sparkfunX/MicroMod_Carrier_Big_Display/Hardware/Production/ordering_instructions.txt

panel size, 141x152mm
PCB thickness, 1.6mm
number of layers, 2
soldermask color, Black
silkscreen color, White
oz copper, 1oz
finish, HASL lead free
stencils, none
pcs per panel, 6
min trace width, 0.1778mm / 0.0070in
min drill size, 0.3048mm / 0.0120in
