sparkfunX/MicroMod_Carrier_Big_Display/(threads)

Thread 1 (2021-03-13):

HDMI_5V is not correct

ralphjy, 2021-03-13:
I am having a problem getting my HDMI monitors to recognize this board as an HDMI source.

It appears that the schematic for the HDMI_5V is incorrect as it should be an output from this board not an input from the monitor.

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

nseidle, 2021-03-16:
This is a truly experimental board. We cannot guarantee it will work with all monitors. That said, we've had it working on multiple monitors around our office in the US and our collaborators in the UK.

The board was designed with the hopes of getting enough current from a TV to run theRP2040. The HDMI spec says

    A sink shall not draw more than 55 mA from the power signal when powered on

See [here](https://www.ti.com/lit/an/snva412c/snva412c.pdf?ts=1615898507918) for more info. While it would have been convenient to power the board directly from a TV, it never worked. We always needed an external power supply.

This board *is* designed to be a HDMI source but we weren't comfortable pushing current into our TVs over the 5V pin. You are welcome to jumper over D5 but I don't think I would recommend it.

Closed 2021-03-16.
