sparkfunX/MicroMod_Carrier_Big_Display/Hardware/Schematic.pdf

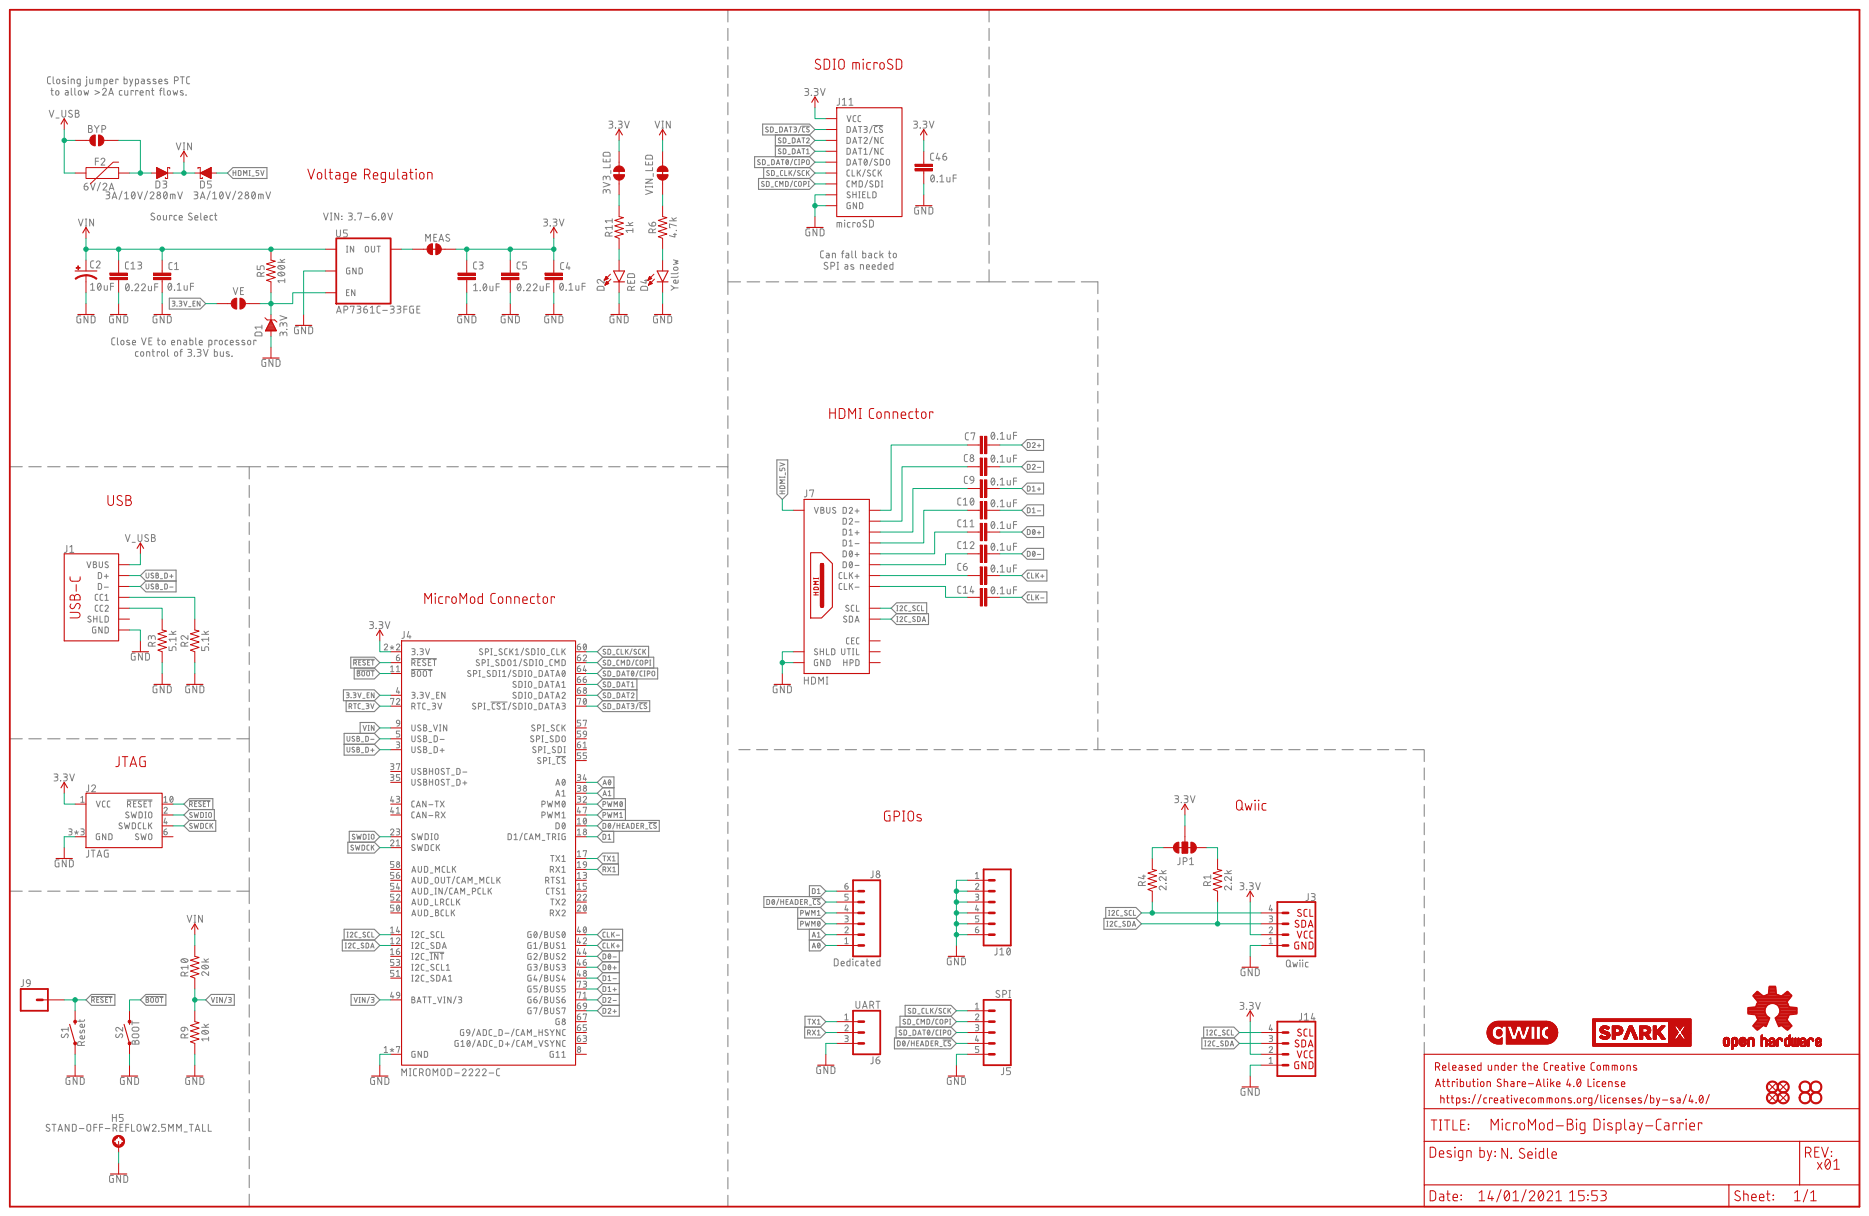
[picture p1: page 1]
