sparkfunX/MicroMod_Carrier_Big_Display/Hardware/MicroMod-Big Display-Carrier.brd

## EAGLE design Hardware/MicroMod-Big Display-Carrier.brd (2021-01-07)

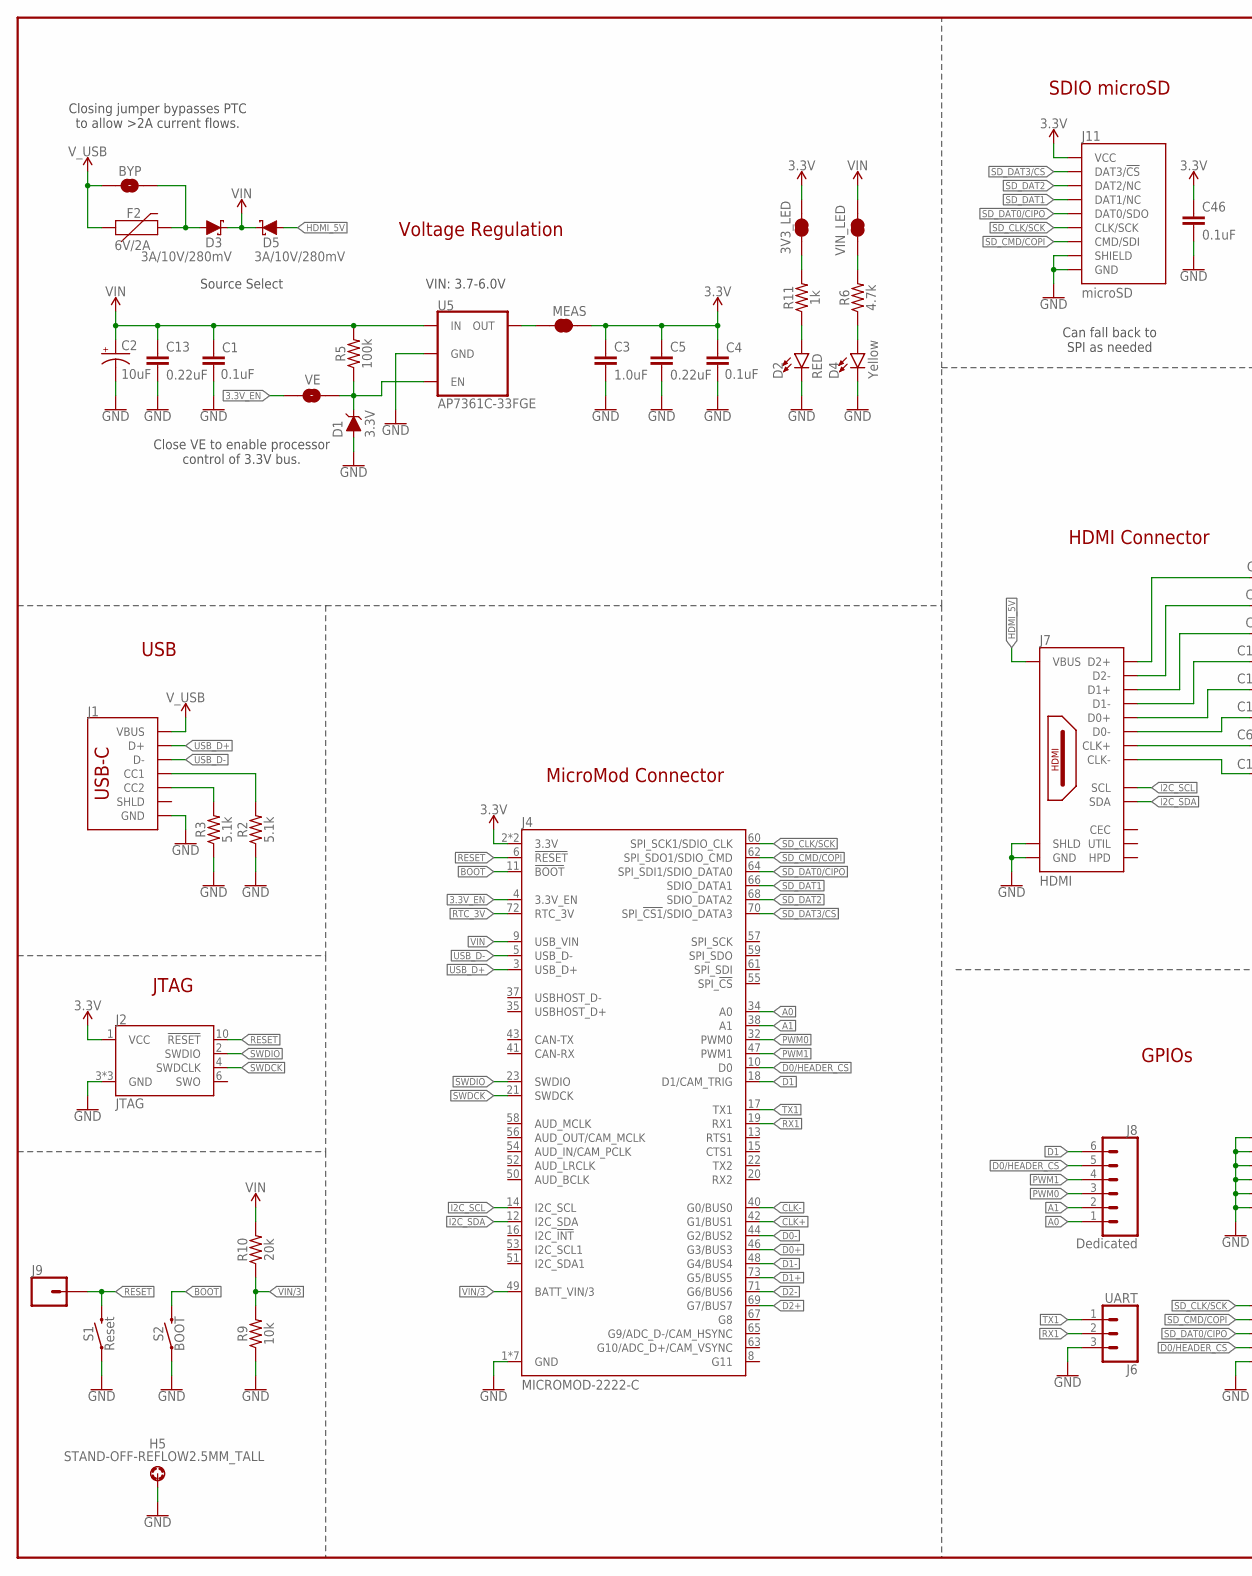
[picture p2: schematic MicroMod-Big Display-Carrier.sch, part in row 1, column 1]

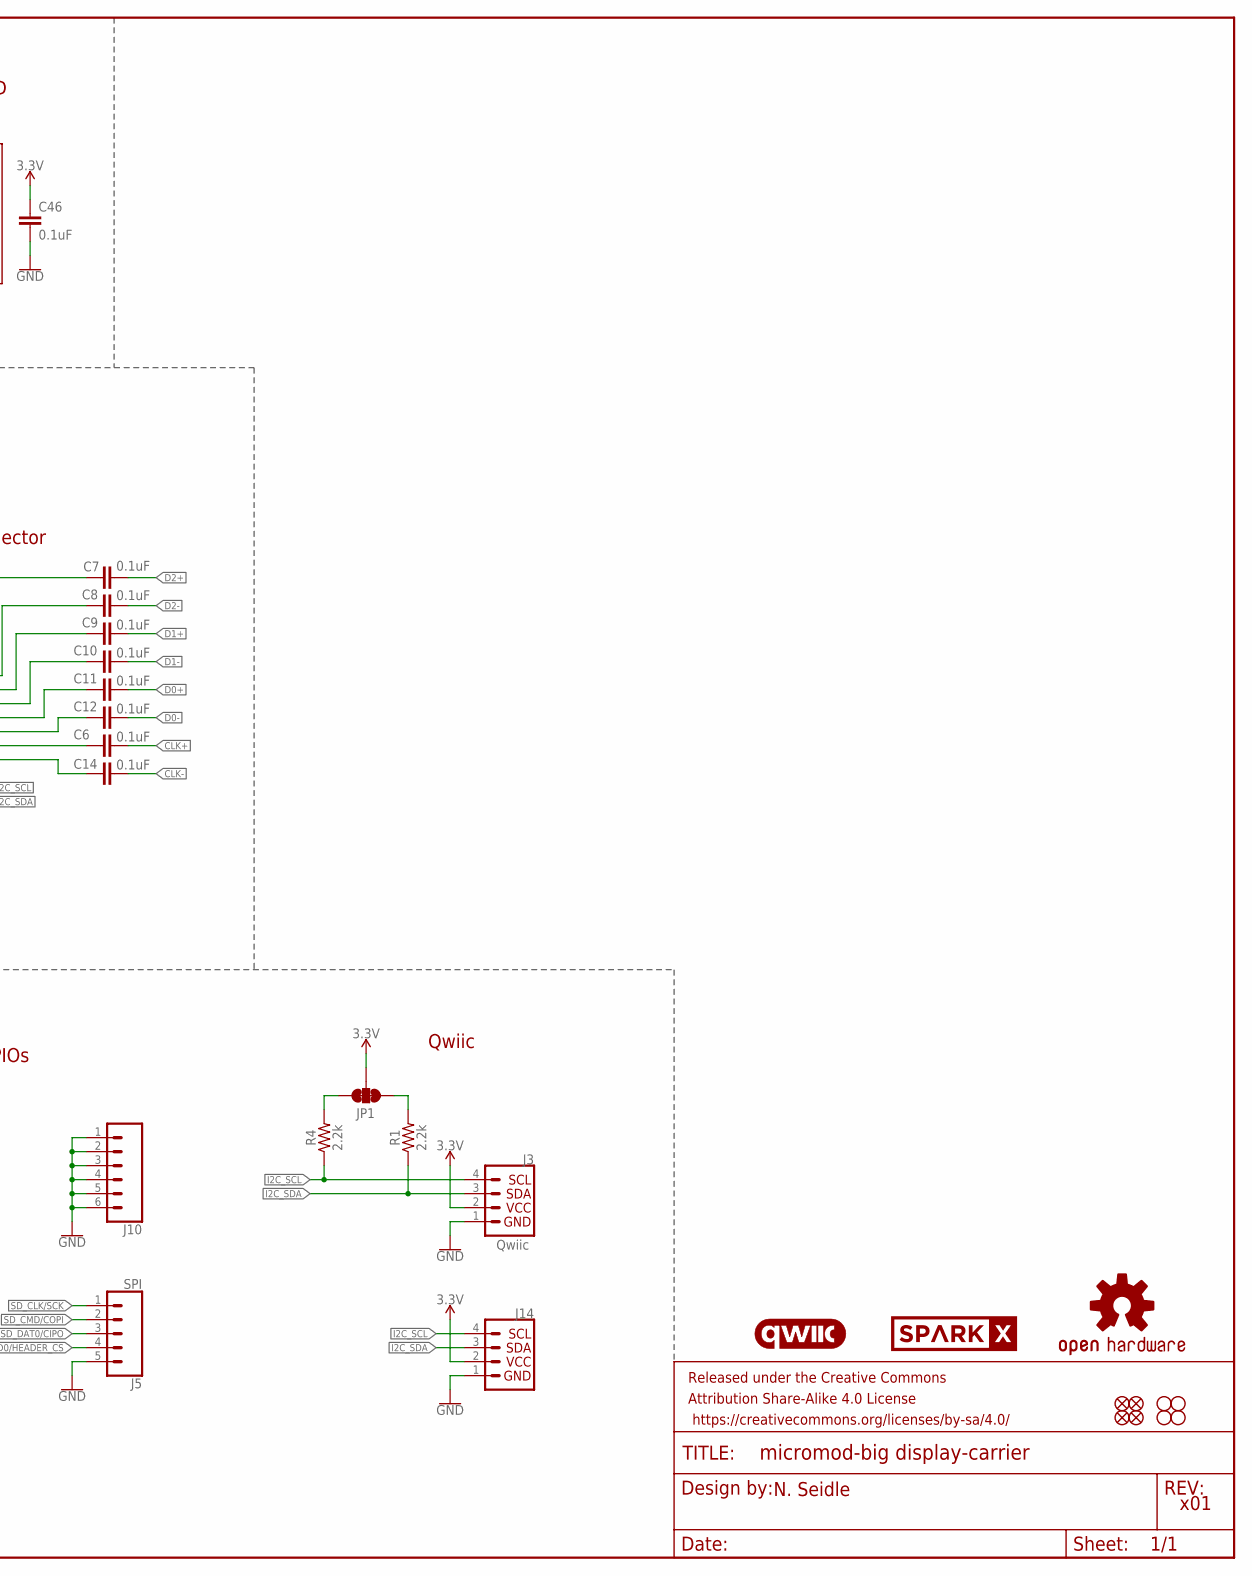
[picture p3: schematic MicroMod-Big Display-Carrier.sch, part in row 1, column 2]

Parts:
3V3_LED: JUMPER-SMT_2_NC_TRACE_SILK; SMT-JUMPER_2_NC_TRACE_SILK
BYP: JUMPER-SMT_2_NO_SILK; SMT-JUMPER_2_NO_SILK
C1, C4, C6, C7, C8, C9, C10, C11, C12, C14, C46: 0.1uF; 0603
C2: 10uF; EIA3216
C3: 1.0uF; 0603
C5, C13: 0.22uF; 0603
D1: 3.3V; SOD-323
D2: RED; LED-0603
D3, D5: 3A/10V/280mV; SOD-323
D4: Yellow; LED-0603
F2: 6V/2A; 1210
FD1, FD2, FD3, FD4: FIDUCIALUFIDUCIAL; FIDUCIAL-MICRO
FRAME1: FRAME-LEDGER; CREATIVE_COMMONS
H1, H2, H3, H4: STAND-OFF
H5: STAND-OFF-REFLOW2.5MM_TALL; STAND-OFF-REFLOW-M2.5
J1: USB_C_2-LAYER_PADS; USB-C-16P-2LAYER-PADS
J2: JTAG; 2X5-PTH-1.27MM
J3: Qwiic; JST04_1MM_RA
J4: MICROMOD-2222-C; M.2-CONNECTOR-E
J5: SPI; 1X05_NO_SILK
J6: UART; 1X03_NO_SILK
J7: HDMI; MOLEX_HDMI_208658-1051
J8: Dedicated; 1X06_NO_SILK
J9: CONN_01PTH_NO_SILK_YES_STOP; 1X01_NO_SILK
J10: CONN_06NO_SILK_NO_POP; 1X06_NO_SILK
J11: microSD; MICRO-SD-SOCKET
J14: I2C_STANDARD_NO_SILK; 1X04_NO_SILK
JP1: JUMPER-SMT_3_2-NC_TRACE_SILK; SMT-JUMPER_3_2-NC_TRACE_SILK
LOGO2: QWIIC_LOGO_CONNECTOR; QWIIC_5.5MM
LOGO3: OSHW-LOGOMINI; OSHW-LOGO-MINI
MEAS: JUMPER-COMBO_2_NC_TRACE; COMBO-JUMPER_2_NC_TRACE
R1, R4: 2.2k; 0603
R2, R3: 5.1k; 0603
R5: 100k; 0603
R6: 4.7k; 0603
R9: 10k; 0603
R10: 20k; 0603
R11: 1k; 0603
S1: Reset; TACTILE_SWITCH_SMD_5.2MM
S2: BOOT; TACTILE_SWITCH_SMD_5.2MM
U5: AP7361C-33FGE; UDFN-8
U$1: SPARKX-LOGO4; SPARKX-MEDIUM
VE: JUMPER-SMT_2_NO_SILK; SMT-JUMPER_2_NO_SILK
VIN_LED: JUMPER-SMT_2_NC_TRACE_SILK; SMT-JUMPER_2_NC_TRACE_SILK

Connections:
3.3V: 3V3_LED.2, C3.1, C4.1, C5.1, C46.1, J2.1 (VCC), J3.2, J4.2 (3.3V), J4.74 (3.3V), J11.VCC, J14.2, JP1.2, MEAS.2, MEAS.4 (2)
3.3V_EN: J4.4 (3.3V_EN), VE.1
!BOOT!: J4.11 (!BOOT!), S2.3 (2), S2.4 (2)
!RESET!: J2.10 (!RESET), J4.6 (!RESET!), J9.1, S1.3 (2), S1.4 (2)
A0: J4.34 (A0), J8.1
A1: J4.38 (A1), J8.2
CLK+: C6.1, J4.42 (G1/BUS1)
CLK-: C14.1, J4.40 (G0/BUS0)
D0+: C11.1, J4.46 (G3/BUS3)
D0-: C12.1, J4.44 (G2/BUS2)
D0/HEADER_!CS!: J4.10 (D0), J5.4, J8.5
D1: J4.18 (D1/CAM_TRIG), J8.6
D1+: C9.1, J4.73 (G5/BUS5)
D1-: C10.1, J4.48 (G4/BUS4)
D2+: C7.1, J4.69 (G7/BUS7)
D2-: C8.1, J4.71 (G6/BUS6)
GND: C1.2, C2.-, C3.2, C4.2, C5.2, C13.2, C46.2, D1.A, D2.C, D4.C, H5.1, J1.GND, J1.GND2 (GND), J2.3 (GND), J2.5 (GND), J2.9 (GND), J3.1, J4.1 (GND), J4.7 (GND), J4.33 (GND), J4.36 (GND), J4.39 (GND), J4.45 (GND), J4.75 (GND), J5.5, J6.3, J7.2 (GND), J7.5 (GND), J7.8 (GND), J7.11 (GND), J7.17 (GND), J7.MH1 (SHLD), J7.MH2 (SHLD), J7.MH3 (SHLD), J7.MH4 (SHLD), J10.1, J10.2, J10.3, J10.4, J10.5, J10.6, J11.CD1 (SHIELD), J11.GND, J11.GND1 (GND), J11.GND3 (GND), J14.1, R2.1, R3.1, R9.1, S1.1, S1.2 (1), S2.1, S2.2 (1), U5.4 (GND), U5.EP (GND)
HDMI_5V: D5.A, J7.18 (VBUS)
I2C_SCL: J3.4, J4.14 (I2C_SCL), J7.15 (SCL), J14.4, R4.1
I2C_SDA: J3.3, J4.12 (I2C_SDA), J7.16 (SDA), J14.3, R1.1
unnamed: R6.2, VIN_LED.1
unnamed: JP1.3, R4.2
unnamed: JP1.1, R1.2
unnamed: C7.2, J7.1 (D2+)
unnamed: C8.2, J7.3 (D2-)
unnamed: 3V3_LED.1, R11.2
unnamed: D2.A, R11.1
unnamed: D4.A, R6.1
unnamed: C9.2, J7.4 (D1+)
unnamed: J1.A5 (CC1), R2.2
unnamed: J1.B5 (CC2), R3.2
unnamed: D1.C, R5.1, U5.5 (EN), VE.2
unnamed: C10.2, J7.6 (D1-)
unnamed: C11.2, J7.7 (D0+)
unnamed: C12.2, J7.9 (D0-)
unnamed: C6.2, J7.10 (CLK+)
unnamed: C14.2, J7.12 (CLK-)
unnamed: BYP.2, D3.A, F2.2
PWM0: J4.32 (PWM0), J8.3
PWM1: J4.47 (PWM1), J8.4
RTC_3V: J4.72 (RTC_3V)
RX1: J4.19 (RX1), J6.2
SD_CLK/SCK: J4.60 (SPI_SCK1/SDIO_CLK), J5.1, J11.SCLK (CLK/SCK)
SD_CMD/COPI: J4.62 (SPI_SDO1/SDIO_CMD), J5.2, J11.DI/CMD (CMD/SDI)
SD_DAT0/CIPO: J4.64 (SPI_SDI1/SDIO_DATA0), J5.3, J11.DO/DAT0 (DAT0/SDO)
SD_DAT1: J4.66 (SDIO_DATA1), J11.DAT1 (DAT1/NC)
SD_DAT2: J4.68 (SDIO_DATA2), J11.DAT2 (DAT2/NC)
SD_DAT3/!CS!: J4.70 (SPI_!CS1!/SDIO_DATA3), J11.CS/DAT3 (DAT3/!CS!)
SWDCK: J2.4 (SWDCLK), J4.21 (SWDCK)
SWDIO: J2.2 (SWDIO), J4.23 (SWDIO)
TX1: J4.17 (TX1), J6.1
USB_D+: J1.A6 (D+), J1.B6 (D+), J4.3 (USB_D+)
USB_D-: J1.A7 (D-), J1.B7 (D-), J4.5 (USB_D-)
VIN: C1.1, C2.+, C13.1, D3.C, D5.C, J4.9 (USB_VIN), R5.2, R10.2, U5.8 (IN), VIN_LED.2
VIN/3: J4.49 (BATT_VIN/3), R9.2, R10.1
VREG_3.3V: MEAS.1, MEAS.3 (1), U5.1 (OUT)
V_USB: BYP.1, F2.1, J1.VBUS1 (VBUS), J1.VBUS2 (VBUS)

Notes on the sheet:
SDIO microSD
Closing jumper bypasses PTC to allow >2A current flows.
JTAG
USB
GPIOs
Qwiic
Voltage Regulation
MicroMod Connector
N. Seidle
x01
VIN: 3.7-6.0V
Close VE to enable processor control of 3.3V bus.
HDMI Connector
Can fall back to SPI as needed
Source Select

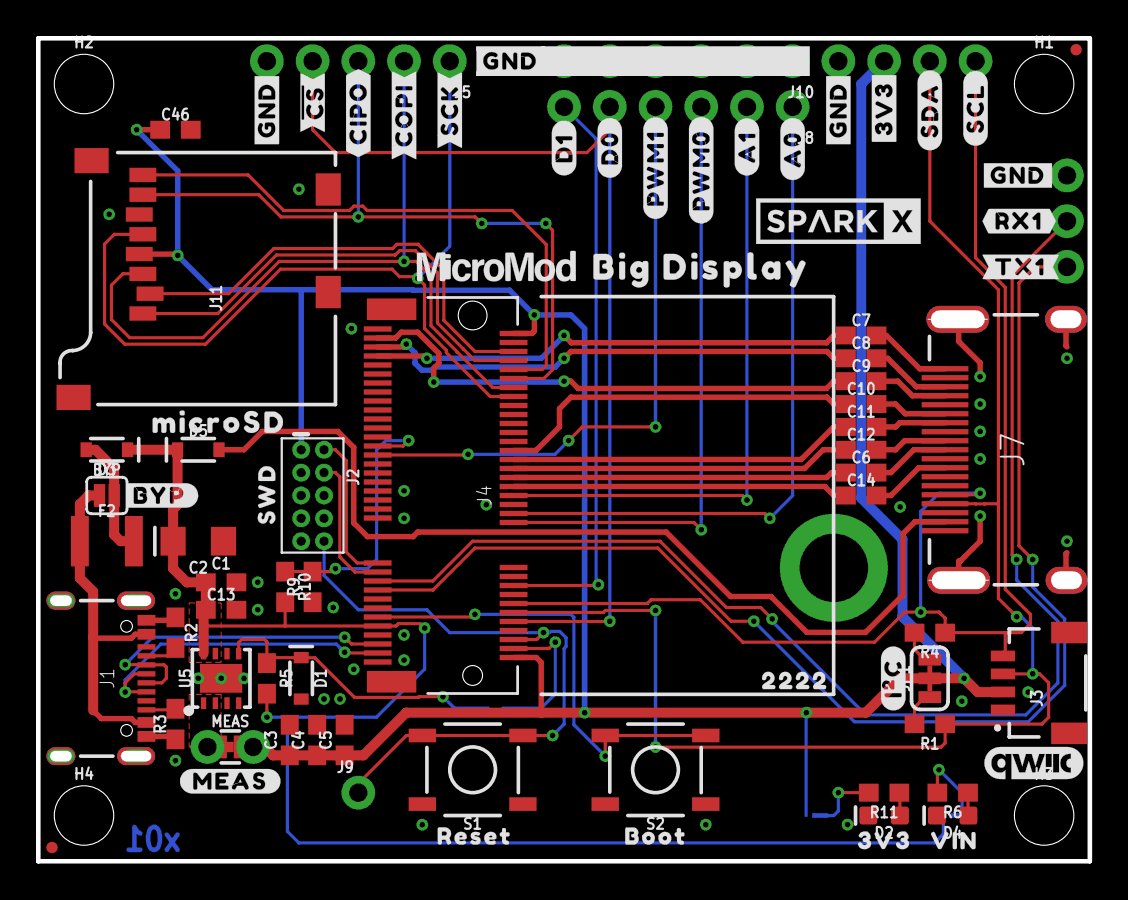
[picture p4: board MicroMod-Big Display-Carrier.brd from above]

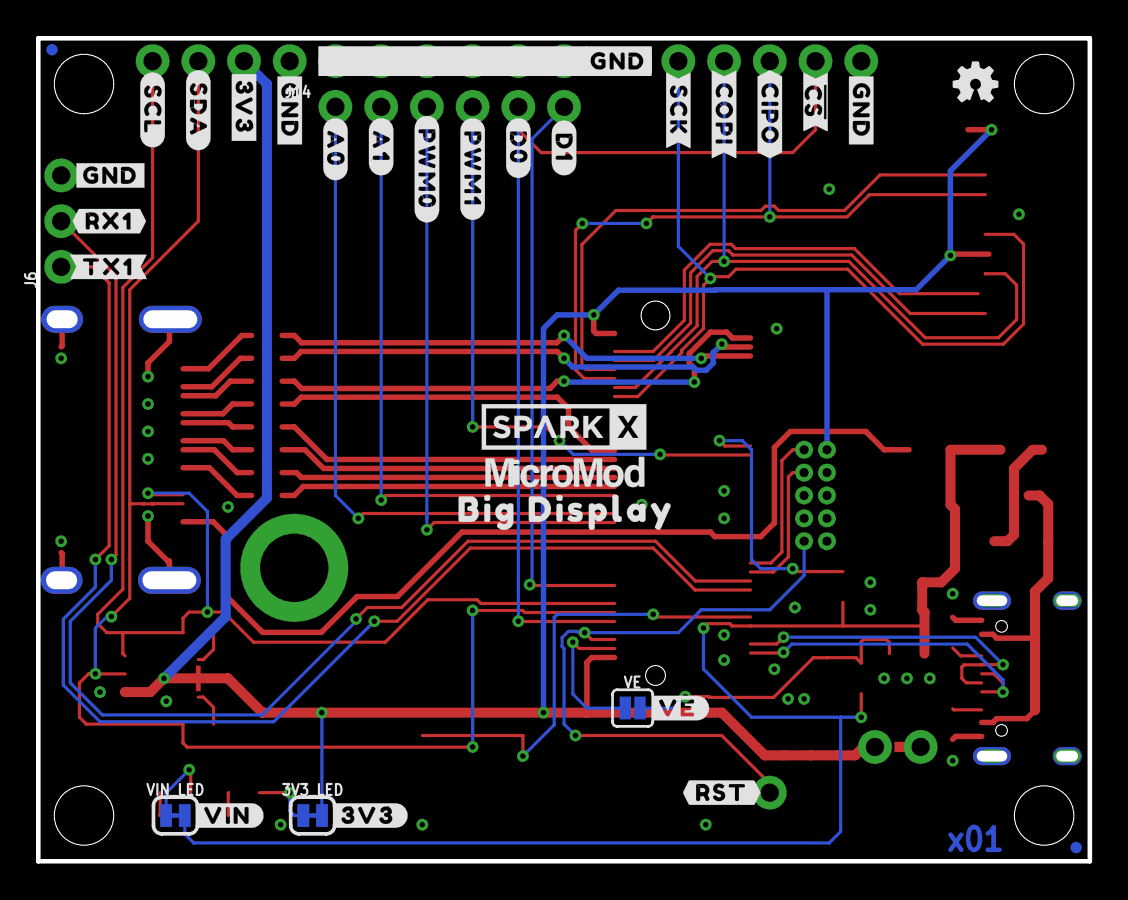
[picture p5: board MicroMod-Big Display-Carrier.brd from below]

Board: 2 copper layers, 58.4 x 45.7 mm, 121 parts (34 on the bottom side), 56 nets.

Other parts of the board:
U$2: MICROSD0
U$3, U$5: BIG_DISPLAY0
U$4: #3V3#0
U$6, U$7: #A0#5
U$8, U$9: #A1#4
U$10, U$25: #D0#1
U$11, U$12, U$15, U$16: #GND#0
U$13, U$14: #3V3#1
U$17: #RST#1
U$18: #VE#0
U$19: #MEAS#2
U$20: #VIN#1
U$21: SWD0
U$22: SPARKX-LOGO4; SPARKX-MEDIUM
U$23: #I�C#0
U$24, U$34: MICROMOD_LOGO_.35
U$29, U$31: #D1#0
U$32, U$41: #PWM0#3
U$33: #BYP#1
U$35, U$68: ##CS##3
U$36: 3V37
U$38: 22223
U$40: BOOT5
U$42, U$49: #PWM1#2
U$43, U$44: #SCL#3
U$45: RESET6
U$46: VIN8
U$50, U$51: #SDA#2
U$69, U$70: #CIPO#2
U$71, U$72: #COPI#1
U$73, U$74, U$81, U$82: #GND#4
U$75, U$76: #RX1#6
U$77, U$78: #SCK#0
U$79, U$80: #TX1#5
