sparkfunX/MicroMod_Carrier_Big_Display/Hardware/Production/MicroMod-Big Display-Carrier-Panel.brd

## EAGLE design Hardware/Production/MicroMod-Big Display-Carrier-Panel.brd (2021-01-07)

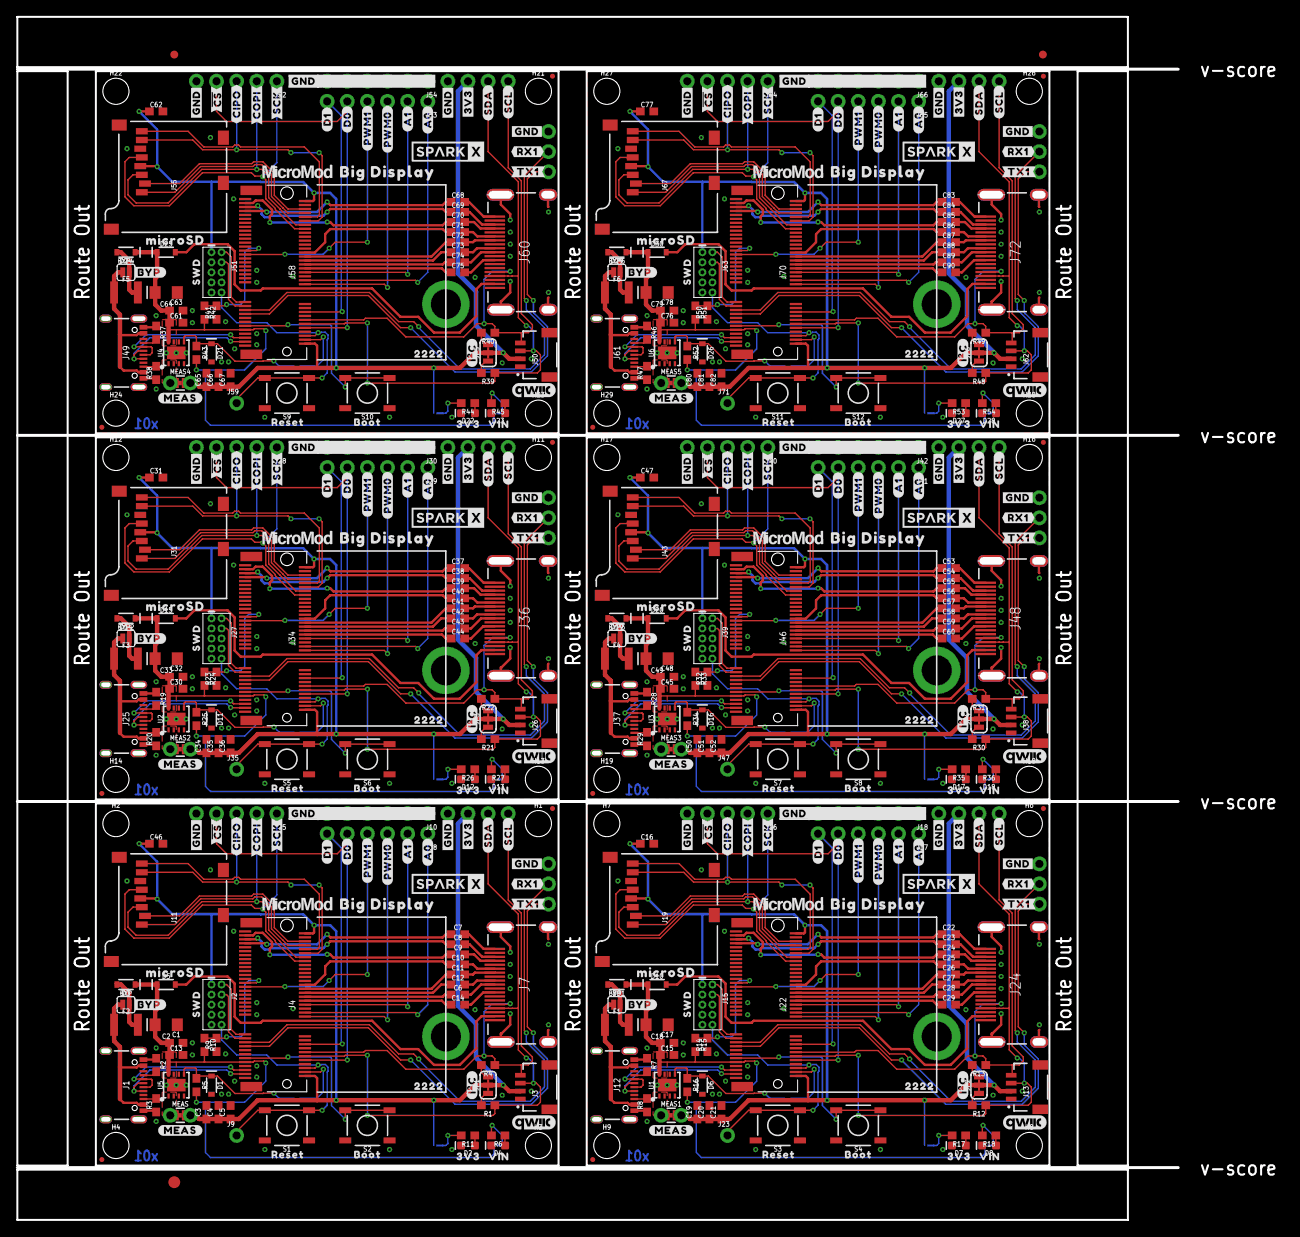
[picture p6: board MicroMod-Big Display-Carrier-Panel.brd from above]

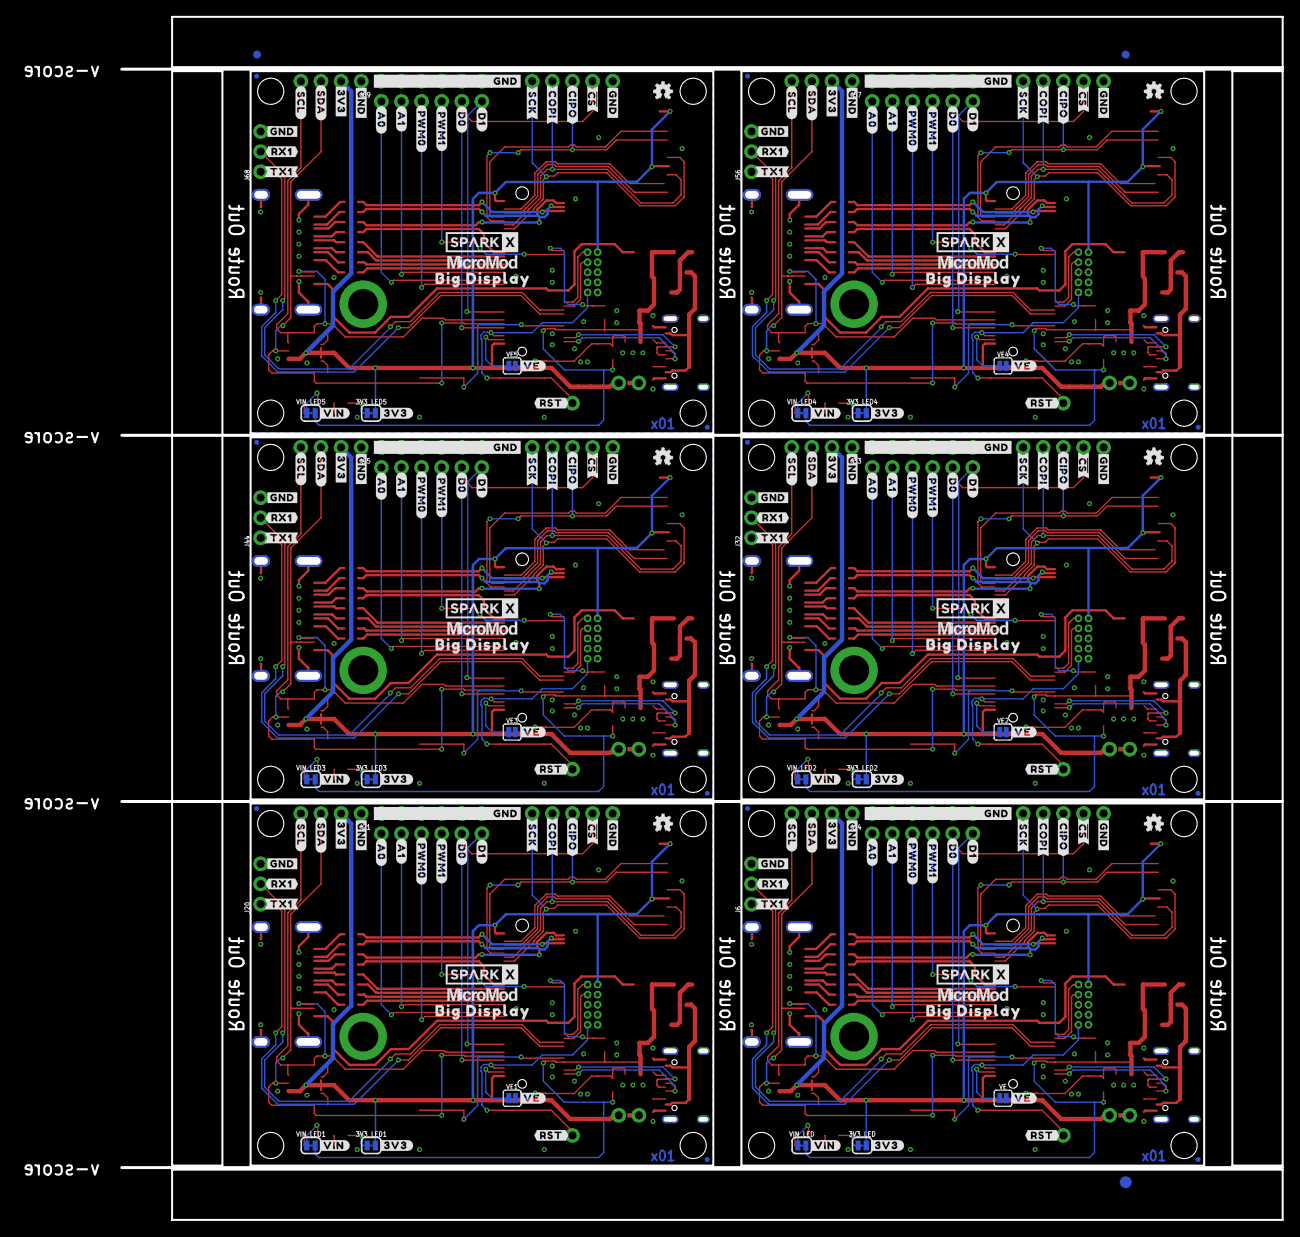
[picture p7: board MicroMod-Big Display-Carrier-Panel.brd from below]

Board: 2 copper layers, 146.6 x 151.9 mm, 726 parts (207 on the bottom side), 336 nets.

Parts:
3V3_LED, 3V3_LED1, 3V3_LED2, 3V3_LED3, 3V3_LED4, 3V3_LED5: SMT-JUMPER_2_NC_TRACE_SILK
BYP, BYP1, BYP2, BYP3, BYP4, BYP5: JUMPER-SMT_2_NO_SILK; SMT-JUMPER_2_NO_SILK
C1, C4, C6, C7, C8, C9, C10, C11, C12, C14, C16, C17, C20, C22, C23, C24, C25, C26, C27, C28, C29, C31, C32, C35, C37, C38, C39, C40, C41, C42, C43, C44, C46, C47, C48, C51, C53, C54, C55, C56, C57, C58, C59, C60, C62, C63, C66, C68, C69, C70, C71, C72, C73, C74, C75, C77, C78, C81, C83, C84, C85, C86, C87, C88, C89, C90: 0.1uF; 0603
C2, C18, C33, C49, C64, C79: 10uF; EIA3216
C3, C19, C34, C50, C65, C80: 1.0uF; 0603
C5, C13, C15, C21, C30, C36, C45, C52, C61, C67, C76, C82: 0.22uF; 0603
D1, D6, D11, D16, D21, D26: 3.3V; SOD-323
D2, D7, D12, D17, D22, D27: RED; LED-0603
D3, D5, D9, D10, D14, D15, D19, D20, D24, D25, D29, D30: 3A/10V/280mV; SOD-323
D4, D8, D13, D18, D23, D28: Yellow; LED-0603
E$1, E$2, E$3, E$4: FIDUCIAL-1X2
E$5, E$6: FIDUCIAL-1.5X3
F1, F2, F3, F4, F5, F6: 6V/2A; 1210
FD1, FD2, FD3, FD4, FD5, FD6, FD7, FD8, FD9, FD10, FD11, FD12, FD13, FD14, FD15, FD16, FD17, FD18, FD19, FD20, FD21, FD22, FD23, FD24: FIDUCIALUFIDUCIAL; FIDUCIAL-MICRO
H1, H2, H3, H4, H6, H7, H8, H9, H11, H12, H13, H14, H16, H17, H18, H19, H21, H22, H23, H24, H26, H27, H28, H29: STAND-OFF
H5, H10, H15, H20, H25, H30: STAND-OFF-REFLOW2.5MM_TALL; STAND-OFF-REFLOW-M2.5
J1, J12, J25, J37, J49, J61: USB-C-16P-2LAYER-PADS
J2, J15, J27, J39, J51, J63: JTAG; 2X5-PTH-1.27MM
J3, J13, J26, J38, J50, J62: Qwiic; JST04_1MM_RA
J4, J22, J34, J46, J58, J70: MICROMOD-2222-C; M.2-CONNECTOR-E
J5, J16, J28, J40, J52, J64: SPI; 1X05_NO_SILK
J6, J20, J32, J44, J56, J68: UART; 1X03_NO_SILK
J7, J24, J36, J48, J60, J72: HDMI; MOLEX_HDMI_208658-1051
J8, J17, J29, J41, J53, J65: Dedicated; 1X06_NO_SILK
J9, J23, J35, J47, J59, J71: 1X01_NO_SILK
J10, J18, J30, J42, J54, J66: 1X06_NO_SILK
J11, J19, J31, J43, J55, J67: microSD; MICRO-SD-SOCKET
J14, J21, J33, J45, J57, J69: 1X04_NO_SILK
JP1, JP2, JP3, JP4, JP5, JP6: SMT-JUMPER_3_2-NC_TRACE_SILK
LOGO1, LOGO2, LOGO5, LOGO7, LOGO9, LOGO11: QWIIC_LOGO_CONNECTOR; QWIIC_5.5MM
LOGO3, LOGO4, LOGO6, LOGO8, LOGO10, LOGO12: OSHW-LOGOMINI; OSHW-LOGO-MINI
MEAS, MEAS1, MEAS2, MEAS3, MEAS4, MEAS5: COMBO-JUMPER_2_NC_TRACE
R1, R4, R12, R13, R21, R22, R30, R31, R39, R40, R48, R49: 2.2k; 0603
R2, R3, R7, R8, R19, R20, R28, R29, R37, R38, R46, R47: 5.1k; 0603
R5, R16, R25, R34, R43, R52: 100k; 0603
R6, R18, R27, R36, R45, R54: 4.7k; 0603
R9, R14, R23, R32, R41, R50: 10k; 0603
R10, R15, R24, R33, R42, R51: 20k; 0603
R11, R17, R26, R35, R44, R53: 1k; 0603
S1, S3, S5, S7, S9, S11: Reset; TACTILE_SWITCH_SMD_5.2MM
S2, S4, S6, S8, S10, S12: BOOT; TACTILE_SWITCH_SMD_5.2MM
U1, U2, U3, U4, U5, U6: AP7361C-33FGE; UDFN-8
U$1, U$22, U$113, U$114, U$171, U$172, U$229, U$230, U$287, U$288, U$345, U$346: SPARKX-LOGO4; SPARKX-MEDIUM
U$2, U$112, U$170, U$228, U$286, U$344: MICROSD0
U$3, U$5, U$115, U$116, U$173, U$174, U$231, U$232, U$289, U$290, U$347, U$348: BIG_DISPLAY0
U$4, U$110, U$168, U$226, U$284, U$342: #3V3#0
U$6, U$7, U$62, U$63, U$135, U$136, U$193, U$194, U$251, U$252, U$309, U$310: #A0#5
U$8, U$9, U$64, U$65, U$137, U$138, U$195, U$196, U$253, U$254, U$311, U$312: #A1#4
U$10, U$25, U$66, U$67, U$139, U$140, U$197, U$198, U$255, U$256, U$313, U$314: #D0#1
U$11, U$12, U$15, U$16, U$89, U$90, U$93, U$94, U$147, U$148, U$151, U$152, U$205, U$206, U$209, U$210, U$263, U$264, U$267, U$268, U$321, U$322, U$325, U$326: #GND#0
U$13, U$14, U$91, U$92, U$149, U$150, U$207, U$208, U$265, U$266, U$323, U$324: #3V3#1
U$17, U$107, U$165, U$223, U$281, U$339: #RST#1
U$18, U$108, U$166, U$224, U$282, U$340: #VE#0
U$19, U$104, U$162, U$220, U$278, U$336: #MEAS#2
U$20, U$111, U$169, U$227, U$285, U$343: #VIN#1
U$21, U$105, U$163, U$221, U$279, U$337: SWD0
U$23, U$109, U$167, U$225, U$283, U$341: #I�C#0
U$24, U$26, U$27, U$34, U$117, U$118, U$175, U$176, U$233, U$234, U$291, U$292: MICROMOD_LOGO_.35
U$28, U$30, U$35, U$68, U$119, U$120, U$177, U$178, U$235, U$236, U$293, U$294: ##CS##3
U$29, U$31, U$83, U$84, U$141, U$142, U$199, U$200, U$257, U$258, U$315, U$316: #D1#0
U$32, U$41, U$85, U$86, U$143, U$144, U$201, U$202, U$259, U$260, U$317, U$318: #PWM0#3
U$33, U$106, U$164, U$222, U$280, U$338: #BYP#1
U$36, U$99, U$157, U$215, U$273, U$331: 3V37
U$37, U$39, U$69, U$70, U$121, U$122, U$179, U$180, U$237, U$238, U$295, U$296: #CIPO#2
U$38, U$100, U$158, U$216, U$274, U$332: 22223
U$40, U$101, U$159, U$217, U$275, U$333: BOOT5
U$42, U$49, U$87, U$88, U$145, U$146, U$203, U$204, U$261, U$262, U$319, U$320: #PWM1#2
U$43, U$44, U$95, U$96, U$153, U$154, U$211, U$212, U$269, U$270, U$327, U$328: #SCL#3
U$45, U$102, U$160, U$218, U$276, U$334: RESET6
U$46, U$103, U$161, U$219, U$277, U$335: VIN8
U$47, U$48, U$71, U$72, U$123, U$124, U$181, U$182, U$239, U$240, U$297, U$298: #COPI#1
U$50, U$51, U$97, U$98, U$155, U$156, U$213, U$214, U$271, U$272, U$329, U$330: #SDA#2
U$52, U$53, U$60, U$61, U$73, U$74, U$81, U$82, U$125, U$126, U$133, U$134, U$183, U$184, U$191, U$192, U$241, U$242, U$249, U$250, U$299, U$300, U$307, U$308: #GND#4
U$54, U$55, U$75, U$76, U$127, U$128, U$185, U$186, U$243, U$244, U$301, U$302: #RX1#6
U$56, U$57, U$77, U$78, U$129, U$130, U$187, U$188, U$245, U$246, U$303, U$304: #SCK#0
U$58, U$59, U$79, U$80, U$131, U$132, U$189, U$190, U$247, U$248, U$305, U$306: #TX1#5
VE, VE1, VE2, VE3, VE4, VE5: SMT-JUMPER_2_NO_SILK
VIN_LED, VIN_LED1, VIN_LED2, VIN_LED3, VIN_LED4, VIN_LED5: SMT-JUMPER_2_NC_TRACE_SILK

Connections:
3.3V: 3V3_LED.2, C3.1, C4.1, C5.1, C46.1, J2.1, J3.2, J4.2, J4.74, J11.VCC, J14.2, JP1.2, MEAS.2, MEAS.4
3.3V1: 3V3_LED1.2, C16.1, C19.1, C20.1, C21.1, J13.2, J15.1, J19.VCC, J21.2, J22.2, J22.74, JP2.2, MEAS1.2, MEAS1.4
3.3V2: 3V3_LED2.2, C31.1, C34.1, C35.1, C36.1, J26.2, J27.1, J31.VCC, J33.2, J34.2, J34.74, JP3.2, MEAS2.2, MEAS2.4
3.3V3: 3V3_LED3.2, C47.1, C50.1, C51.1, C52.1, J38.2, J39.1, J43.VCC, J45.2, J46.2, J46.74, JP4.2, MEAS3.2, MEAS3.4
3.3V4: 3V3_LED4.2, C62.1, C65.1, C66.1, C67.1, J50.2, J51.1, J55.VCC, J57.2, J58.2, J58.74, JP5.2, MEAS4.2, MEAS4.4
3.3V5: 3V3_LED5.2, C77.1, C80.1, C81.1, C82.1, J62.2, J63.1, J67.VCC, J69.2, J70.2, J70.74, JP6.2, MEAS5.2, MEAS5.4
3.3V_EN: J4.4, VE.1
3.3V_EN1: J22.4, VE1.1
3.3V_EN2: J34.4, VE2.1
3.3V_EN3: J46.4, VE3.1
3.3V_EN4: J58.4, VE4.1
3.3V_EN5: J70.4, VE5.1
!BOOT!: J4.11, S2.3, S2.4
!BOOT!1: J22.11, S4.3, S4.4
!BOOT!2: J34.11, S6.3, S6.4
!BOOT!3: J46.11, S8.3, S8.4
!BOOT!4: J58.11, S10.3, S10.4
!BOOT!5: J70.11, S12.3, S12.4
!RESET!: J2.10, J4.6, J9.1, S1.3, S1.4
!RESET!1: J15.10, J22.6, J23.1, S3.3, S3.4
!RESET!2: J27.10, J34.6, J35.1, S5.3, S5.4
!RESET!3: J39.10, J46.6, J47.1, S7.3, S7.4
!RESET!4: J51.10, J58.6, J59.1, S9.3, S9.4
!RESET!5: J63.10, J70.6, J71.1, S11.3, S11.4
A0: J4.34, J8.1
A1: J4.38, J8.2
A2: J17.1, J22.34
A3: J17.2, J22.38
A4: J29.1, J34.34
A5: J29.2, J34.38
A6: J41.1, J46.34
A7: J41.2, J46.38
A8: J53.1, J58.34
A9: J53.2, J58.38
A10: J65.1, J70.34
A11: J65.2, J70.38
CLK+: C6.1, J4.42
CLK+1: C28.1, J22.42
CLK+2: C43.1, J34.42
CLK+3: C59.1, J46.42
CLK+4: C74.1, J58.42
CLK+5: C89.1, J70.42
CLK-: C14.1, J4.40
CLK-1: C29.1, J22.40
CLK-2: C44.1, J34.40
CLK-3: C60.1, J46.40
CLK-4: C75.1, J58.40
CLK-5: C90.1, J70.40
D0+: C11.1, J4.46
D0+1: C26.1, J22.46
D0+2: C41.1, J34.46
D0+3: C57.1, J46.46
D0+4: C72.1, J58.46
D0+5: C87.1, J70.46
D0-: C12.1, J4.44
D0-1: C27.1, J22.44
D0-2: C42.1, J34.44
D0-3: C58.1, J46.44
D0-4: C73.1, J58.44
D0-5: C88.1, J70.44
D0/HEADER_!CS!: J4.10, J5.4, J8.5
D0/HEADER_!CS!1: J16.4, J17.5, J22.10
D0/HEADER_!CS!2: J28.4, J29.5, J34.10
D0/HEADER_!CS!3: J40.4, J41.5, J46.10
D0/HEADER_!CS!4: J52.4, J53.5, J58.10
D0/HEADER_!CS!5: J64.4, J65.5, J70.10
D1: J4.18, J8.6
D1+: C9.1, J4.73
D1+1: C24.1, J22.73
D1+2: C39.1, J34.73
D1+3: C55.1, J46.73
D1+4: C70.1, J58.73
D1+5: C85.1, J70.73
D1-: C10.1, J4.48
D1-1: C25.1, J22.48
D1-2: C40.1, J34.48
D1-3: C56.1, J46.48
D1-4: C71.1, J58.48
D1-5: C86.1, J70.48
D2: J17.6, J22.18
D2+: C7.1, J4.69
D2+1: C22.1, J22.69
D2+2: C37.1, J34.69
D2+3: C53.1, J46.69
D2+4: C68.1, J58.69
D2+5: C83.1, J70.69
D2-: C8.1, J4.71
D2-1: C23.1, J22.71
D2-2: C38.1, J34.71
D2-3: C54.1, J46.71
D2-4: C69.1, J58.71
D2-5: C84.1, J70.71
D3: J29.6, J34.18
D4: J41.6, J46.18
D5: J53.6, J58.18
D6: J65.6, J70.18
GND: C1.2, C2.-, C3.2, C4.2, C5.2, C13.2, C46.2, D1.A, D2.C, D4.C, H5.1, J1.GND, J1.GND2, J2.3, J2.5, J2.9, J3.1, J4.1, J4.7, J4.33, J4.36, J4.39, J4.45, J4.75, J5.5, J6.3, J7.2, J7.5, J7.8, J7.11, J7.17, J7.MH1, J7.MH2, J7.MH3, J7.MH4, J10.1, J10.2, J10.3, J10.4, J10.5, J10.6, J11.CD1, J11.GND, J11.GND1, J11.GND3, J14.1, R2.1, R3.1, R9.1, S1.1, S1.2, S2.1, S2.2, U5.4, U5.EP
GND1: C15.2, C16.2, C17.2, C18.-, C19.2, C20.2, C21.2, D6.A, D7.C, D8.C, H10.1, J12.GND, J12.GND2, J13.1, J15.3, J15.5, J15.9, J16.5, J18.1, J18.2, J18.3, J18.4, J18.5, J18.6, J19.CD1, J19.GND, J19.GND1, J19.GND3, J20.3, J21.1, J22.1, J22.7, J22.33, J22.36, J22.39, J22.45, J22.75, J24.2, J24.5, J24.8, J24.11, J24.17, J24.MH1, J24.MH2, J24.MH3, J24.MH4, R7.1, R8.1, R14.1, S3.1, S3.2, S4.1, S4.2, U1.4, U1.EP
GND2: C30.2, C31.2, C32.2, C33.-, C34.2, C35.2, C36.2, D11.A, D12.C, D13.C, H15.1, J25.GND, J25.GND2, J26.1, J27.3, J27.5, J27.9, J28.5, J30.1, J30.2, J30.3, J30.4, J30.5, J30.6, J31.CD1, J31.GND, J31.GND1, J31.GND3, J32.3, J33.1, J34.1, J34.7, J34.33, J34.36, J34.39, J34.45, J34.75, J36.2, J36.5, J36.8, J36.11, J36.17, J36.MH1, J36.MH2, J36.MH3, J36.MH4, R19.1, R20.1, R23.1, S5.1, S5.2, S6.1, S6.2, U2.4, U2.EP
GND3: C45.2, C47.2, C48.2, C49.-, C50.2, C51.2, C52.2, D16.A, D17.C, D18.C, H20.1, J37.GND, J37.GND2, J38.1, J39.3, J39.5, J39.9, J40.5, J42.1, J42.2, J42.3, J42.4, J42.5, J42.6, J43.CD1, J43.GND, J43.GND1, J43.GND3, J44.3, J45.1, J46.1, J46.7, J46.33, J46.36, J46.39, J46.45, J46.75, J48.2, J48.5, J48.8, J48.11, J48.17, J48.MH1, J48.MH2, J48.MH3, J48.MH4, R28.1, R29.1, R32.1, S7.1, S7.2, S8.1, S8.2, U3.4, U3.EP
GND4: C61.2, C62.2, C63.2, C64.-, C65.2, C66.2, C67.2, D21.A, D22.C, D23.C, H25.1, J49.GND, J49.GND2, J50.1, J51.3, J51.5, J51.9, J52.5, J54.1, J54.2, J54.3, J54.4, J54.5, J54.6, J55.CD1, J55.GND, J55.GND1, J55.GND3, J56.3, J57.1, J58.1, J58.7, J58.33, J58.36, J58.39, J58.45, J58.75, J60.2, J60.5, J60.8, J60.11, J60.17, J60.MH1, J60.MH2, J60.MH3, J60.MH4, R37.1, R38.1, R41.1, S9.1, S9.2, S10.1, S10.2, U4.4, U4.EP
GND5: C76.2, C77.2, C78.2, C79.-, C80.2, C81.2, C82.2, D26.A, D27.C, D28.C, H30.1, J61.GND, J61.GND2, J62.1, J63.3, J63.5, J63.9, J64.5, J66.1, J66.2, J66.3, J66.4, J66.5, J66.6, J67.CD1, J67.GND, J67.GND1, J67.GND3, J68.3, J69.1, J70.1, J70.7, J70.33, J70.36, J70.39, J70.45, J70.75, J72.2, J72.5, J72.8, J72.11, J72.17, J72.MH1, J72.MH2, J72.MH3, J72.MH4, R46.1, R47.1, R50.1, S11.1, S11.2, S12.1, S12.2, U6.4, U6.EP
HDMI_5V: D5.A, J7.18
HDMI_5V1: D10.A, J24.18
HDMI_5V2: D15.A, J36.18
HDMI_5V3: D20.A, J48.18
HDMI_5V4: D25.A, J60.18
HDMI_5V5: D30.A, J72.18
I2C_SCL: J3.4, J4.14, J7.15, J14.4, R4.1
I2C_SCL1: J13.4, J21.4, J22.14, J24.15, R13.1
I2C_SCL2: J26.4, J33.4, J34.14, J36.15, R22.1
I2C_SCL3: J38.4, J45.4, J46.14, J48.15, R31.1
I2C_SCL4: J50.4, J57.4, J58.14, J60.15, R40.1
I2C_SCL5: J62.4, J69.4, J70.14, J72.15, R49.1
I2C_SDA: J3.3, J4.12, J7.16, J14.3, R1.1
I2C_SDA1: J13.3, J21.3, J22.12, J24.16, R12.1
I2C_SDA2: J26.3, J33.3, J34.12, J36.16, R21.1
I2C_SDA3: J38.3, J45.3, J46.12, J48.16, R30.1
I2C_SDA4: J50.3, J57.3, J58.12, J60.16, R39.1
I2C_SDA5: J62.3, J69.3, J70.12, J72.16, R48.1
unnamed: R6.2, VIN_LED.1
unnamed: JP1.3, R4.2
unnamed: JP1.1, R1.2
unnamed: C7.2, J7.1
unnamed: C8.2, J7.3
unnamed: 3V3_LED.1, R11.2
unnamed: D2.A, R11.1
unnamed: D4.A, R6.1
unnamed: C9.2, J7.4
unnamed: J1.A5, R2.2
unnamed: J1.B5, R3.2
unnamed: D1.C, R5.1, U5.5, VE.2
unnamed: C10.2, J7.6
unnamed: C11.2, J7.7
unnamed: C12.2, J7.9
unnamed: C6.2, J7.10
unnamed: C14.2, J7.12
unnamed: BYP.2, D3.A, F2.2
unnamed: J12.A5, R7.2
unnamed: J12.B5, R8.2
unnamed: JP2.3, R13.2
unnamed: JP2.1, R12.2
unnamed: 3V3_LED1.1, R17.2
unnamed: D7.A, R17.1
unnamed: R18.2, VIN_LED1.1
unnamed: D8.A, R18.1
unnamed: D6.C, R16.1, U1.5, VE1.2
unnamed: C22.2, J24.1
unnamed: C23.2, J24.3
unnamed: C24.2, J24.4
unnamed: C25.2, J24.6
unnamed: C28.2, J24.10
unnamed: C29.2, J24.12
unnamed: C26.2, J24.7
unnamed: C27.2, J24.9
unnamed: BYP1.2, D9.A, F1.2
unnamed: J25.A5, R19.2
unnamed: J25.B5, R20.2
unnamed: JP3.3, R22.2
unnamed: JP3.1, R21.2
unnamed: 3V3_LED2.1, R26.2
unnamed: D12.A, R26.1
unnamed: R27.2, VIN_LED2.1
unnamed: D13.A, R27.1
unnamed: D11.C, R25.1, U2.5, VE2.2
unnamed: C37.2, J36.1
unnamed: C38.2, J36.3
unnamed: C39.2, J36.4
unnamed: C40.2, J36.6
unnamed: C43.2, J36.10
unnamed: C44.2, J36.12
unnamed: C41.2, J36.7
unnamed: C42.2, J36.9
unnamed: BYP2.2, D14.A, F3.2
unnamed: J37.A5, R28.2
unnamed: J37.B5, R29.2
unnamed: JP4.3, R31.2
unnamed: JP4.1, R30.2
unnamed: 3V3_LED3.1, R35.2
unnamed: D17.A, R35.1
unnamed: R36.2, VIN_LED3.1
unnamed: D18.A, R36.1
unnamed: D16.C, R34.1, U3.5, VE3.2
unnamed: C53.2, J48.1
unnamed: C54.2, J48.3
unnamed: C55.2, J48.4
unnamed: C56.2, J48.6
unnamed: C59.2, J48.10
unnamed: C60.2, J48.12
unnamed: C57.2, J48.7
unnamed: C58.2, J48.9
unnamed: BYP3.2, D19.A, F4.2
unnamed: J49.A5, R37.2
unnamed: J49.B5, R38.2
unnamed: JP5.3, R40.2
unnamed: JP5.1, R39.2
unnamed: 3V3_LED4.1, R44.2
unnamed: D22.A, R44.1
unnamed: R45.2, VIN_LED4.1
unnamed: D23.A, R45.1
unnamed: D21.C, R43.1, U4.5, VE4.2
unnamed: C68.2, J60.1
unnamed: C69.2, J60.3
unnamed: C70.2, J60.4
unnamed: C71.2, J60.6
unnamed: C74.2, J60.10
unnamed: C75.2, J60.12
unnamed: C72.2, J60.7
unnamed: C73.2, J60.9
unnamed: BYP4.2, D24.A, F5.2
unnamed: J61.A5, R46.2
unnamed: J61.B5, R47.2
unnamed: JP6.3, R49.2
unnamed: JP6.1, R48.2
unnamed: 3V3_LED5.1, R53.2
unnamed: D27.A, R53.1
unnamed: R54.2, VIN_LED5.1
unnamed: D28.A, R54.1
unnamed: D26.C, R52.1, U6.5, VE5.2
unnamed: C83.2, J72.1
unnamed: C84.2, J72.3
unnamed: C85.2, J72.4
unnamed: C86.2, J72.6
unnamed: C89.2, J72.10
unnamed: C90.2, J72.12
unnamed: C87.2, J72.7
unnamed: C88.2, J72.9
unnamed: BYP5.2, D29.A, F6.2
PWM0: J4.32, J8.3
PWM1: J4.47, J8.4
PWM2: J17.3, J22.32
PWM3: J17.4, J22.47
PWM4: J29.3, J34.32
PWM5: J29.4, J34.47
PWM6: J41.3, J46.32
PWM7: J41.4, J46.47
PWM8: J53.3, J58.32
PWM9: J53.4, J58.47
PWM10: J65.3, J70.32
PWM11: J65.4, J70.47
RX1: J4.19, J6.2
RX2: J20.2, J22.19
RX3: J32.2, J34.19
RX4: J44.2, J46.19
RX5: J56.2, J58.19
RX6: J68.2, J70.19
SD_CLK/SCK: J4.60, J5.1, J11.SCLK
SD_CLK/SCK1: J16.1, J19.SCLK, J22.60
SD_CLK/SCK2: J28.1, J31.SCLK, J34.60
SD_CLK/SCK3: J40.1, J43.SCLK, J46.60
SD_CLK/SCK4: J52.1, J55.SCLK, J58.60
SD_CLK/SCK5: J64.1, J67.SCLK, J70.60
SD_CMD/COPI: J4.62, J5.2, J11.DI/CMD
SD_CMD/COPI1: J16.2, J19.DI/CMD, J22.62
SD_CMD/COPI2: J28.2, J31.DI/CMD, J34.62
SD_CMD/COPI3: J40.2, J43.DI/CMD, J46.62
SD_CMD/COPI4: J52.2, J55.DI/CMD, J58.62
SD_CMD/COPI5: J64.2, J67.DI/CMD, J70.62
SD_DAT0/CIPO: J4.64, J5.3, J11.DO/DAT0
SD_DAT0/CIPO1: J16.3, J19.DO/DAT0, J22.64
SD_DAT0/CIPO2: J28.3, J31.DO/DAT0, J34.64
SD_DAT0/CIPO3: J40.3, J43.DO/DAT0, J46.64
SD_DAT0/CIPO4: J52.3, J55.DO/DAT0, J58.64
SD_DAT0/CIPO5: J64.3, J67.DO/DAT0, J70.64
SD_DAT1: J4.66, J11.DAT1
SD_DAT2: J4.68, J11.DAT2
SD_DAT3: J19.DAT1, J22.66
SD_DAT3/!CS!: J4.70, J11.CS/DAT3
SD_DAT3/!CS!1: J19.CS/DAT3, J22.70
SD_DAT3/!CS!2: J31.CS/DAT3, J34.70
SD_DAT3/!CS!3: J43.CS/DAT3, J46.70
SD_DAT3/!CS!4: J55.CS/DAT3, J58.70
SD_DAT3/!CS!5: J67.CS/DAT3, J70.70
SD_DAT4: J19.DAT2, J22.68
SD_DAT5: J31.DAT1, J34.66
SD_DAT6: J31.DAT2, J34.68
SD_DAT7: J43.DAT1, J46.66
SD_DAT8: J43.DAT2, J46.68
SD_DAT9: J55.DAT1, J58.66
SD_DAT10: J55.DAT2, J58.68
SD_DAT11: J67.DAT1, J70.66
SD_DAT12: J67.DAT2, J70.68
SWDCK: J2.4, J4.21
SWDCK1: J15.4, J22.21
SWDCK2: J27.4, J34.21
SWDCK3: J39.4, J46.21
SWDCK4: J51.4, J58.21
SWDCK5: J63.4, J70.21
SWDIO: J2.2, J4.23
SWDIO1: J15.2, J22.23
SWDIO2: J27.2, J34.23
SWDIO3: J39.2, J46.23
SWDIO4: J51.2, J58.23
SWDIO5: J63.2, J70.23
TX1: J4.17, J6.1
TX2: J20.1, J22.17
TX3: J32.1, J34.17
TX4: J44.1, J46.17
TX5: J56.1, J58.17
TX6: J68.1, J70.17
USB_D+: J1.A6, J1.B6, J4.3
USB_D+1: J12.A6, J12.B6, J22.3
USB_D+2: J25.A6, J25.B6, J34.3
USB_D+3: J37.A6, J37.B6, J46.3
USB_D+4: J49.A6, J49.B6, J58.3
USB_D+5: J61.A6, J61.B6, J70.3
USB_D-: J1.A7, J1.B7, J4.5
USB_D-1: J12.A7, J12.B7, J22.5
USB_D-2: J25.A7, J25.B7, J34.5
USB_D-3: J37.A7, J37.B7, J46.5
USB_D-4: J49.A7, J49.B7, J58.5
USB_D-5: J61.A7, J61.B7, J70.5
VIN: C1.1, C2.+, C13.1, D3.C, D5.C, J4.9, R5.2, R10.2, U5.8, VIN_LED.2
VIN1: C15.1, C17.1, C18.+, D9.C, D10.C, J22.9, R15.2, R16.2, U1.8, VIN_LED1.2
VIN2: C30.1, C32.1, C33.+, D14.C, D15.C, J34.9, R24.2, R25.2, U2.8, VIN_LED2.2
VIN3: C45.1, C48.1, C49.+, D19.C, D20.C, J46.9, R33.2, R34.2, U3.8, VIN_LED3.2
VIN4: C61.1, C63.1, C64.+, D24.C, D25.C, J58.9, R42.2, R43.2, U4.8, VIN_LED4.2
VIN5: C76.1, C78.1, C79.+, D29.C, D30.C, J70.9, R51.2, R52.2, U6.8, VIN_LED5.2
VIN/1: J22.49, R14.2, R15.1
VIN/2: J34.49, R23.2, R24.1
VIN/3: J4.49, R9.2, R10.1
VIN/4: J46.49, R32.2, R33.1
VIN/5: J58.49, R41.2, R42.1
VIN/6: J70.49, R50.2, R51.1
VREG_3.3V: MEAS.1, MEAS.3, U5.1
VREG_3.3V1: MEAS1.1, MEAS1.3, U1.1
VREG_3.3V2: MEAS2.1, MEAS2.3, U2.1
VREG_3.3V3: MEAS3.1, MEAS3.3, U3.1
VREG_3.3V4: MEAS4.1, MEAS4.3, U4.1
VREG_3.3V5: MEAS5.1, MEAS5.3, U6.1
V_USB: BYP.1, F2.1, J1.VBUS1, J1.VBUS2
V_USB1: BYP1.1, F1.1, J12.VBUS1, J12.VBUS2
V_USB2: BYP2.1, F3.1, J25.VBUS1, J25.VBUS2
V_USB3: BYP3.1, F4.1, J37.VBUS1, J37.VBUS2
V_USB4: BYP4.1, F5.1, J49.VBUS1, J49.VBUS2
V_USB5: BYP5.1, F6.1, J61.VBUS1, J61.VBUS2
