sparkfunX/MicroMod_Carrier_Big_Display/(commit log)

2021-01-07 Update silk
    [MicroMod-Big Display-Carrier-Panel.GBL, MicroMod-Big Display-Carrier-Panel.GBO, MicroMod-Big Display-Carrier-Panel.GBP, MicroMod-Big Display-Carrier-Panel.GBS, MicroMod-Big Display-Carrier-Panel.GKO, MicroMod-Big Display-Carrier-Panel.GTL, MicroMod-Big Display-Carrier-Panel.GTO, MicroMod-Big Display-Carrier-Panel.GTP]
2021-01-14 Adding the schematic in pdf format
